KASIRGA-KIZIL/tekno-kizil/README.md

# tekno-kizil

## KASIRGA - KIZIL Takımı Teknofest 2023 Yonga Tasarımı

**TEKNOFEST 2023 Çip Tasarım Yarışması Sayısal İşlemci Kategorisi Birincisi**



**KIZIL İşlemci Projesi**

**Danışman:** &nbsp;&nbsp;&nbsp;&nbsp;&nbsp;&nbsp;&nbsp;&nbsp;&nbsp;Prof. Dr. Oğuz Ergin

**Takım Kaptanı:** &nbsp;&nbsp;Seyyid Hikmet Çelik

&emsp;&emsp;&emsp;&emsp;&emsp;&emsp;&emsp;&emsp;Emre Hakan Demirli

&emsp;&emsp;&emsp;&emsp;&emsp;&emsp;&emsp;&emsp;Mehmet Şakir Aslan

&emsp;&emsp;&emsp;&emsp;&emsp;&emsp;&emsp;&emsp;Ahmet Emre Oluk

&emsp;&emsp;&emsp;&emsp;&emsp;&emsp;&emsp;&emsp;Ege Deveci

**Youtube Sunum Videosu:**
https://www.youtube.com/watch?v=Kw16yyKHfTI

**Yarışma Sitesi:** 
https://teknofest.org/tr/competitions/competition/121

**Şartname (TR):** 
https://cdn.teknofest.org/media/upload/userFormUpload/Teknofest_%C3%87ip_%C5%9Eartnamesi_2023_v8_paylasilan_naLIQ.pdf

**Şartname (EN):**
https://cdn.teknofest.org/media/upload/userFormUpload/Teknofest_Chip_Specifications_2023_v5_paylasilan_kivby.pdf

## İşlemci Serimi

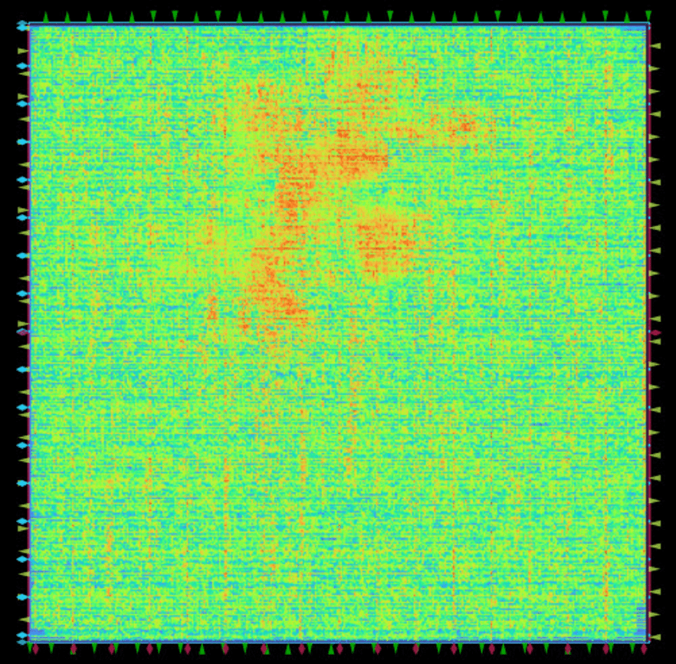
[picture p1: dokumanlar/islemci_serimi.png]


## İşlemci Özellikleri

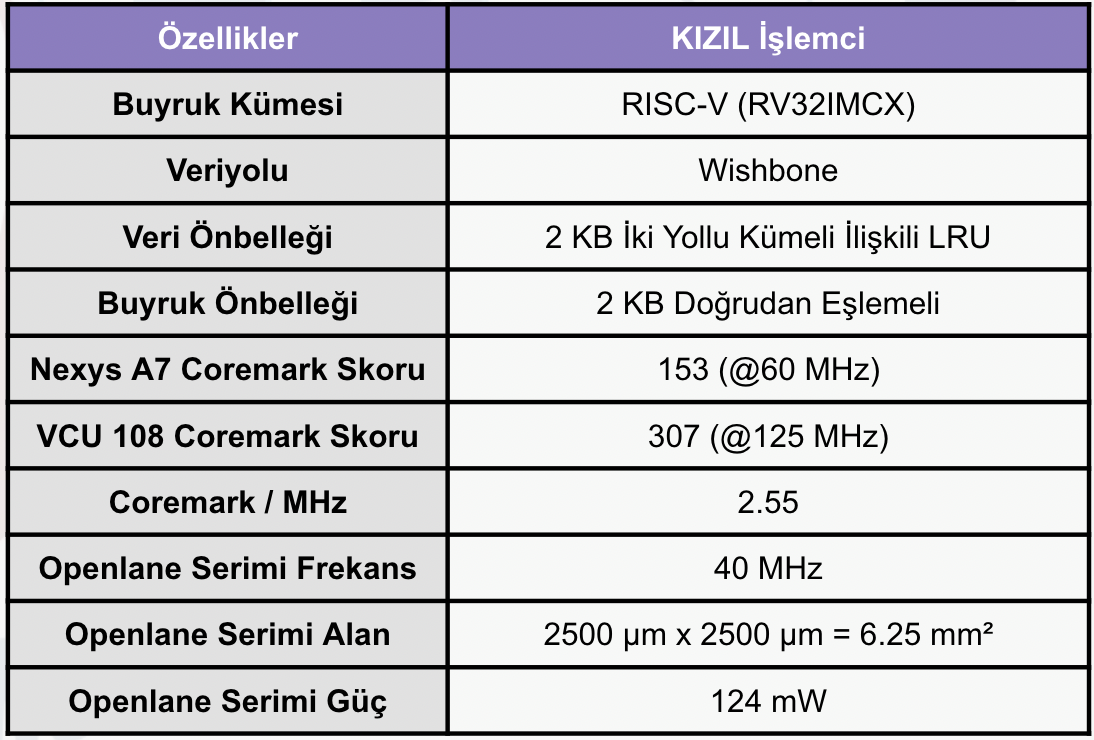
[picture p2: dokumanlar/islemci_ozellikleri_tablo.png]


## Sistem Yapısı

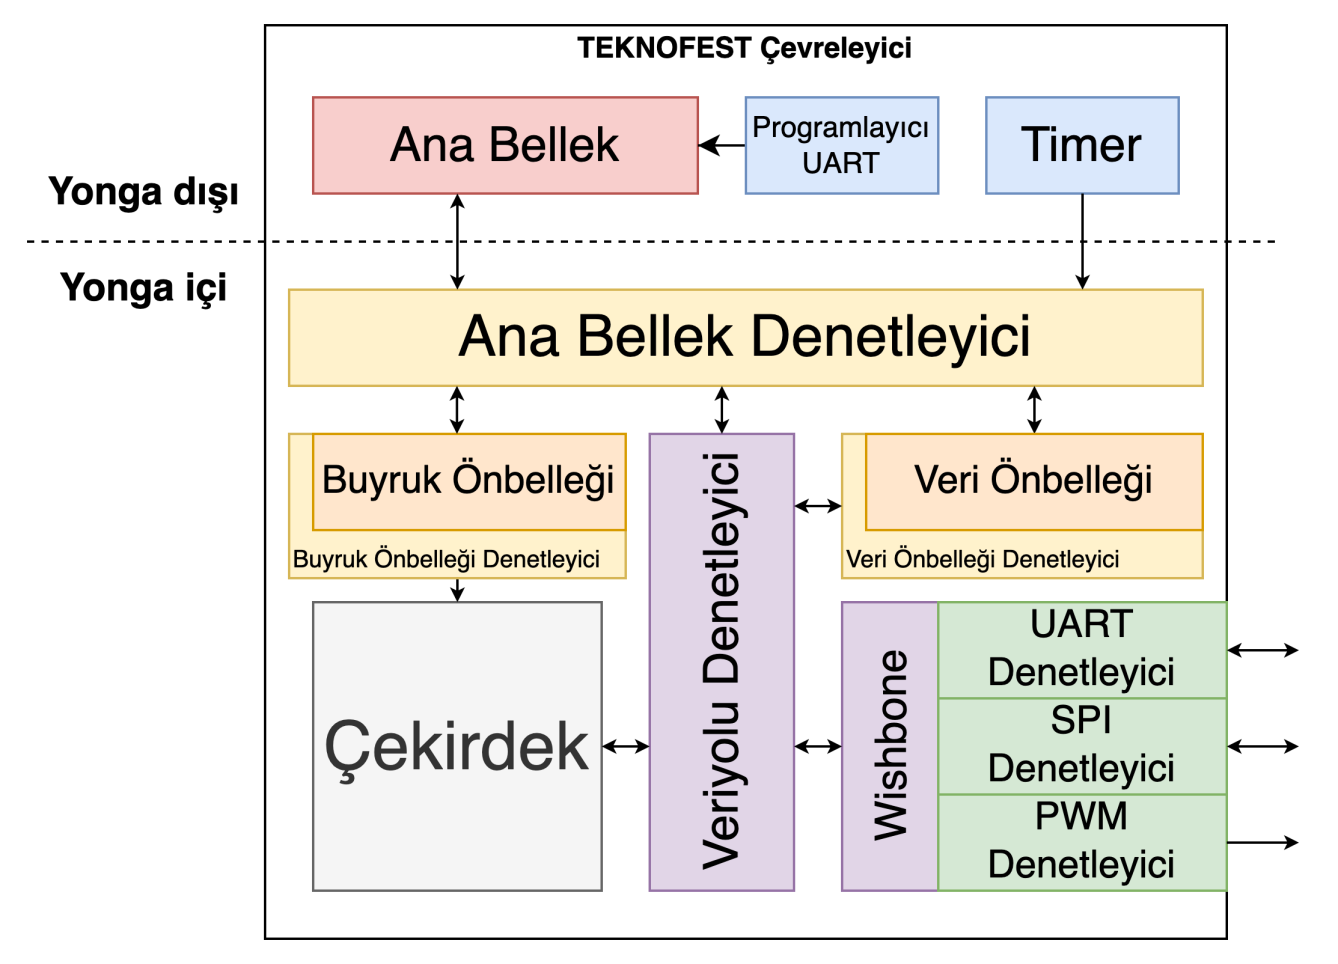
[picture p3: dokumanlar/sistem_yapisi_dtr.png]


## Çekirdek Yapısı - Boru Hattı

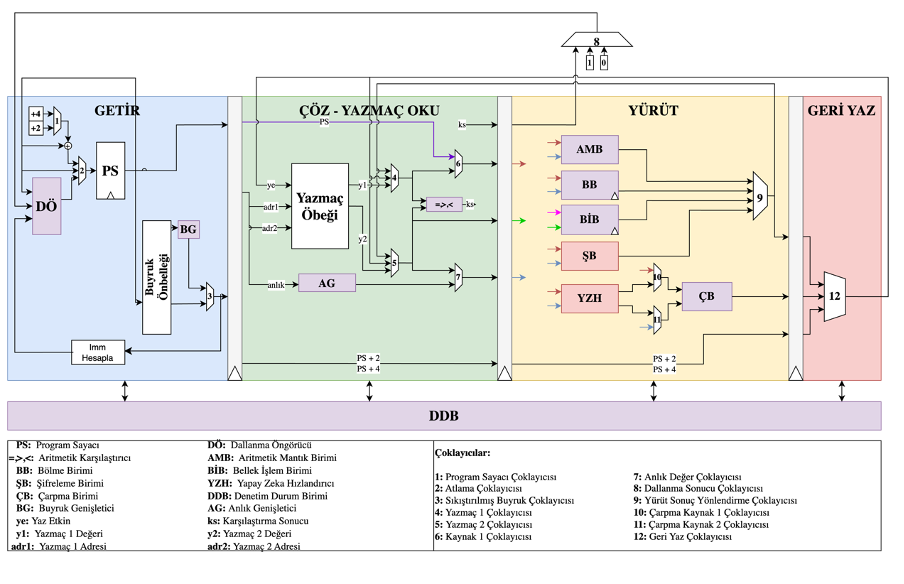
[picture p4: dokumanlar/cekirdek_yapisi_dtr.png]


## CoreMark Karşılaştırma Grafiği

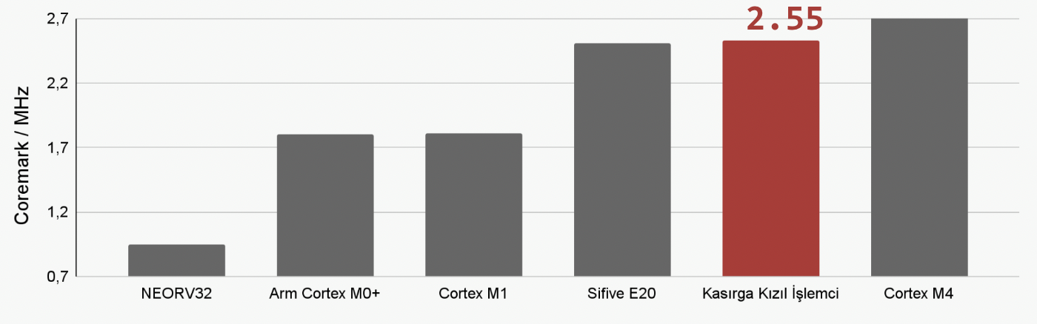
[picture p5: dokumanlar/coremark_karsilastirma.png]


## OPENLANE
OpenLane github dosyaları: ``` tekno-kizil/openlane/kizil_islemci```<br>
OpenLane commiti: ```commit dc8e6bb151df7ee2b93d7e9d6a15abf6f224db4d (HEAD, tag: 2023.03.12)```

open_pdks commiti: ```commit e6f9c8876da77220403014b116761b0b2d79aab4```

OpenLane dosyaları zip: 
https://drive.google.com/drive/folders/1dEIMV9H3JBl-_G-wRf3G_0qm45DjGziY?usp=sharing

Alternatif link:
https://etuedutr-my.sharepoint.com/:f:/g/personal/seyyidhikmetcelik_etu_edu_tr/En43TU66Nl1Ji5QVRtBFXAcBxOaddUdlfn2X91mqJWlFJw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
<br>
