KASIRGA-KIZIL/tekno-kizil/araclar/README.md

Uart programlayıcıyı basys3 gibi bir FPGA'e atarak ve python kodlarını kullanarak FPGA'yi programlayabilirsiniz.
