KASIRGA-KIZIL/tekno-kizil/vivado/README.md

## 3 FPGA İÇİN VIVADO DOSYALARI

NEXYS A7-100T --> 60 MHz 

*NEXYS için olan dosyalar teknofest_wrapper şeklinde, mesela teknofest_wrapper.bit, diğer fpgaler için kendi isminde*

VCU 108 --> 125 MHz (programlayıcı uart baudrate'i farklı --> 115200)

BASYS3 --> 60 MHz (sığmadığı için rami daha az --> 0x20000 yerine 0x5000 satır)
