KASIRGA-KIZIL/tekno-kizil/dokumanlar/cekirdek_yapisi.png

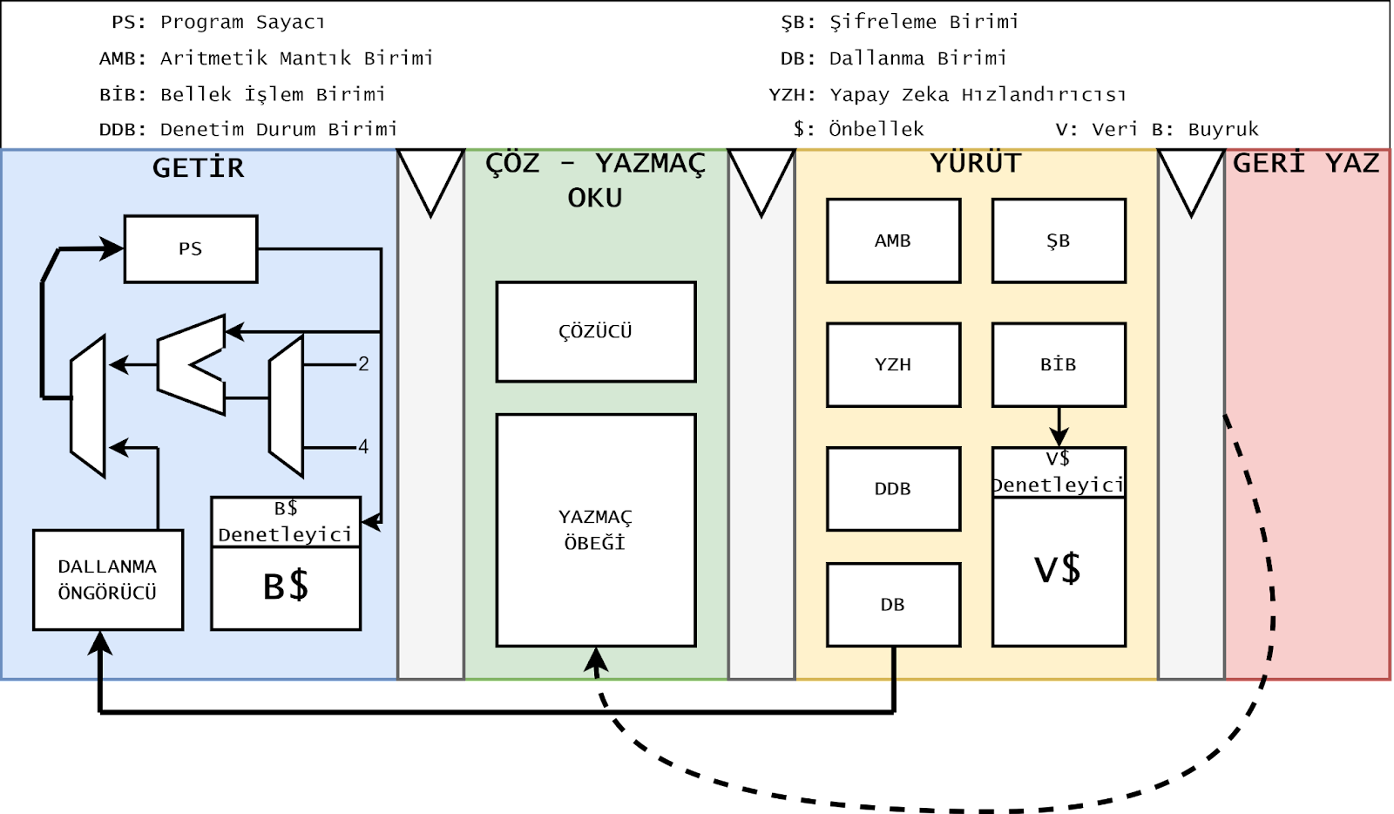
dokumanlar/cekirdek_yapisi.png
