KASIRGA-KIZIL/tekno-kizil/dokumanlar/cekirdek_yapisi_detayli.png

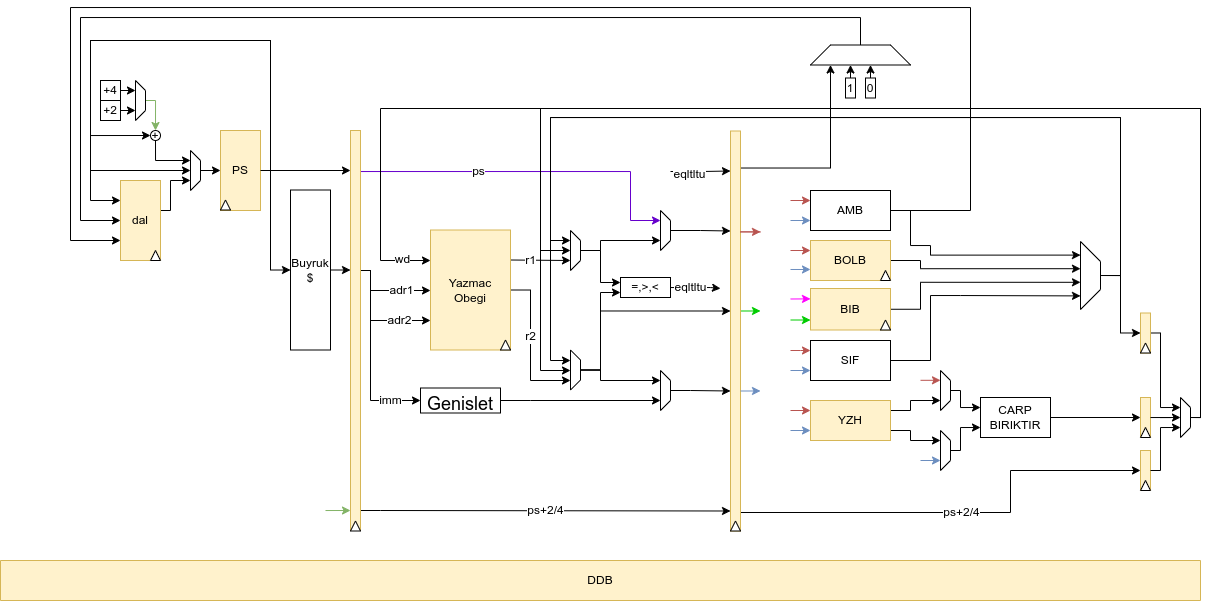
dokumanlar/cekirdek_yapisi_detayli.png
