KASIRGA-KIZIL/tekno-kizil/dokumanlar/sistem_yapisi_detayli.png

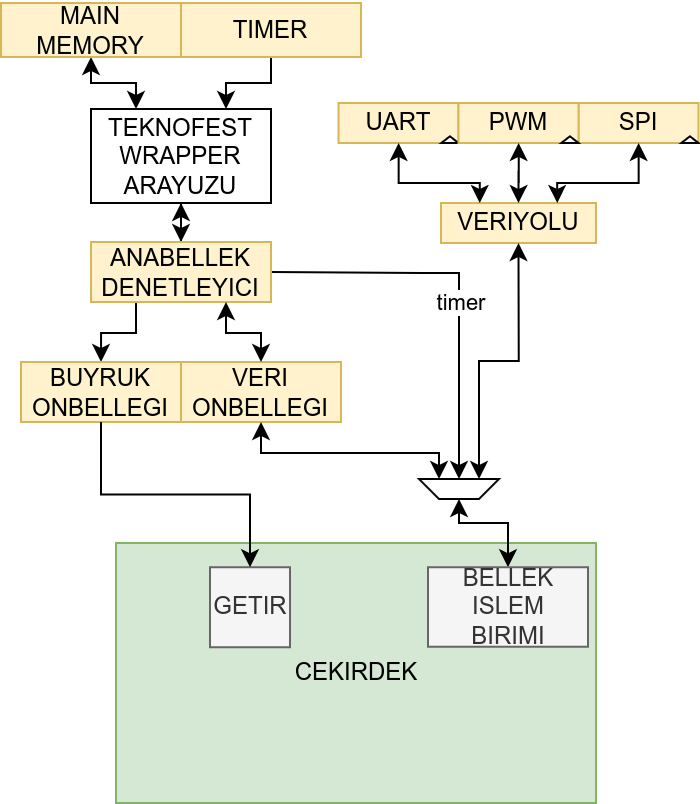
dokumanlar/sistem_yapisi_detayli.png
