KASIRGA-KIZIL/tekno-kizil/testler/spi-demo/spi_demo_disassembled.txt

spi_demo.riscv:     file format elf32-littleriscv

Disassembly of section .text:

40000000 <main>:
40000000:	200107b7          	lui	x15,0x20010
40000004:	09800713          	addi	x14,x0,152
40000008:	00e7a623          	sw	x14,12(x15) # 2001000c <main-0x1ffefff4>
4000000c:	000f0737          	lui	x14,0xf0
40000010:	00170713          	addi	x14,x14,1 # f0001 <main-0x3ff0ffff>
40000014:	00e7a023          	sw	x14,0(x15)
40000018:	00002737          	lui	x14,0x2
4000001c:	00e7a823          	sw	x14,16(x15)
40000020:	20010737          	lui	x14,0x20010
40000024:	00472783          	lw	x15,4(x14) # 20010004 <main-0x1ffefffc>
40000028:	0027f793          	andi	x15,x15,2
4000002c:	fe078ce3          	beq	x15,x0,40000024 <main+0x24>
40000030:	09800793          	addi	x15,x0,152
40000034:	00f72623          	sw	x15,12(x14)
40000038:	000f07b7          	lui	x15,0xf0
4000003c:	00578793          	addi	x15,x15,5 # f0005 <main-0x3ff0fffb>
40000040:	00f72023          	sw	x15,0(x14)
40000044:	000027b7          	lui	x15,0x2
40000048:	00f72823          	sw	x15,16(x14)
4000004c:	20010737          	lui	x14,0x20010
40000050:	00472783          	lw	x15,4(x14) # 20010004 <main-0x1ffefffc>
40000054:	0027f793          	andi	x15,x15,2
40000058:	fe078ce3          	beq	x15,x0,40000050 <main+0x50>
4000005c:	09800793          	addi	x15,x0,152
40000060:	00f72623          	sw	x15,12(x14)
40000064:	000f07b7          	lui	x15,0xf0
40000068:	00978793          	addi	x15,x15,9 # f0009 <main-0x3ff0fff7>
4000006c:	00f72023          	sw	x15,0(x14)
40000070:	000027b7          	lui	x15,0x2
40000074:	00f72823          	sw	x15,16(x14)
40000078:	20010737          	lui	x14,0x20010
4000007c:	00472783          	lw	x15,4(x14) # 20010004 <main-0x1ffefffc>
40000080:	0027f793          	andi	x15,x15,2
40000084:	fe078ce3          	beq	x15,x0,4000007c <main+0x7c>
40000088:	09800793          	addi	x15,x0,152
4000008c:	00f72623          	sw	x15,12(x14)
40000090:	000f07b7          	lui	x15,0xf0
40000094:	00d78793          	addi	x15,x15,13 # f000d <main-0x3ff0fff3>
40000098:	00f72023          	sw	x15,0(x14)
4000009c:	000027b7          	lui	x15,0x2
400000a0:	00f72823          	sw	x15,16(x14)
400000a4:	0000006f          	jal	x0,400000a4 <main+0xa4>
