KASIRGA-KIZIL/tekno-kizil/(threads)

Thread 8 (2023-05-05):

SPI mode 3 is non functional

hakan-demirli, 2023-05-05:
mode 3 in SPI read operation is broken. Incoming data is shifted by 4 bits.
