KASIRGA-KIZIL/tekno-kizil/openlane/kizil_islemci/src/toplayici.v

`include "tanimlamalar.vh"

`ifndef OPENLANE
// https://github.com/tdene/synth_opt_adders tarafindan olusturulmus optimize toplayici
/*
	width = 33
	f = forest(width, alias = "sklansky")
	f.hdl('adder_mapped.v', optimization = 0, mapping = "sky130_fd_sc_hd") # ayrica aynisinin behavioural versiyonu
*/
module toplayici(
	input  [32:0] a_in,
	input  [32:0] b_in,
	output [32:0] sum
);
	wire n8_tree_32, n9_tree_32, n10_tree_32, n11_tree_32, n12_tree_32, n13_tree_32, n16_tree_32, n17_tree_32, n18_tree_31, n18_tree_32, n19_tree_31, n19_tree_32, n20_tree_32, n21_tree_32, n24_tree_32, n25_tree_32, n26_tree_32, n27_tree_32, n28_tree_32, n29_tree_32, n32_tree_32, n33_tree_32, n34_tree_31, n34_tree_32, n35_tree_31, n35_tree_32, n36_tree_32, n37_tree_32, n38_tree_30, n39_tree_30, n40_tree_32, n41_tree_32, n42_tree_32, n43_tree_32, n44_tree_32, n45_tree_32, n48_tree_32, n49_tree_32, n50_tree_31, n50_tree_32, n51_tree_31, n51_tree_32, n52_tree_32, n53_tree_32, n56_tree_32, n57_tree_32, n58_tree_32, n59_tree_32, n60_tree_32, n61_tree_32, n64_tree_32, n65_tree_32, n66_tree_31, n66_tree_32, n67_tree_31, n67_tree_32, n68_tree_32, n69_tree_32, n70_tree_30, n71_tree_30, n72_tree_32, n73_tree_32, n74_tree_32, n75_tree_32, n76_tree_32, n77_tree_32, n80_tree_32, n81_tree_32, n82_tree_31, n82_tree_32, n83_tree_31, n83_tree_32, n84_tree_32, n85_tree_32, n88_tree_32, n89_tree_32, n90_tree_32, n91_tree_32, n92_tree_32, n93_tree_32, n96_tree_32, n97_tree_32, n98_tree_31, n98_tree_32, n99_tree_31, n99_tree_32, n100_tree_32, n101_tree_32, n104_tree_32, n105_tree_32, n106_tree_32, n107_tree_32, n108_tree_32, n109_tree_32, n112_tree_32, n113_tree_32, n114_tree_28, n114_tree_32, n115_tree_32, n116_tree_32, n117_tree_32, n119_tree_29, n120_tree_32, n121_tree_32, n124_tree_30, n124_tree_32, n125_tree_32, n129_tree_31, n134_tree_32;

	adder_tree_32 U0(
		.a_in(a_in[32:0]),
		.b_in(b_in[32:0]),
		.sum(sum[32]),
		.n125_tree_32(n125_tree_32),
		.n124_tree_32(n124_tree_32),
		.n121_tree_32(n121_tree_32),
		.n120_tree_32(n120_tree_32),
		.n117_tree_32(n117_tree_32),
		.n116_tree_32(n116_tree_32),
		.n113_tree_32(n113_tree_32),
		.n112_tree_32(n112_tree_32),
		.n109_tree_32(n109_tree_32),
		.n108_tree_32(n108_tree_32),
		.n105_tree_32(n105_tree_32),
		.n104_tree_32(n104_tree_32),
		.n101_tree_32(n101_tree_32),
		.n100_tree_32(n100_tree_32),
		.n97_tree_32(n97_tree_32),
		.n96_tree_32(n96_tree_32),
		.n93_tree_32(n93_tree_32),
		.n92_tree_32(n92_tree_32),
		.n89_tree_32(n89_tree_32),
		.n88_tree_32(n88_tree_32),
		.n85_tree_32(n85_tree_32),
		.n84_tree_32(n84_tree_32),
		.n81_tree_32(n81_tree_32),
		.n80_tree_32(n80_tree_32),
		.n77_tree_32(n77_tree_32),
		.n76_tree_32(n76_tree_32),
		.n73_tree_32(n73_tree_32),
		.n72_tree_32(n72_tree_32),
		.n69_tree_32(n69_tree_32),
		.n68_tree_32(n68_tree_32),
		.n65_tree_32(n65_tree_32),
		.n64_tree_32(n64_tree_32),
		.n61_tree_32(n61_tree_32),
		.n60_tree_32(n60_tree_32),
		.n57_tree_32(n57_tree_32),
		.n56_tree_32(n56_tree_32),
		.n53_tree_32(n53_tree_32),
		.n52_tree_32(n52_tree_32),
		.n49_tree_32(n49_tree_32),
		.n48_tree_32(n48_tree_32),
		.n45_tree_32(n45_tree_32),
		.n44_tree_32(n44_tree_32),
		.n41_tree_32(n41_tree_32),
		.n40_tree_32(n40_tree_32),
		.n37_tree_32(n37_tree_32),
		.n36_tree_32(n36_tree_32),
		.n33_tree_32(n33_tree_32),
		.n32_tree_32(n32_tree_32),
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
    assign n133_tree_32 = (n134_tree_32&n125_tree_32)|n124_tree_32;
    assign n134_tree_32 = a_in[0]&b_in[0];
    assign sum = n129_tree_32^n135_tree_32;
    assign n135_tree_32 = a_in[32]^b_in[32];
endmodule // adder_tree_32
`endif
