KASIRGA-KIZIL/tekno-kizil/openlane/kizil_islemci/src/toplayici_sky130.v

`include "tanimlamalar.vh"

`ifdef OPENLANE

module toplayici_sky130(
	input  [32:0] a_in,
	input  [32:0] b_in,
	output [32:0] sum
);
	wire n8_tree_32, n9_tree_32, n10_tree_32, n11_tree_32, n12_tree_32, n13_tree_32, n16_tree_32, n17_tree_32, n18_tree_31, n18_tree_32, n19_tree_31, n19_tree_32, n20_tree_32, n21_tree_32, n24_tree_32, n25_tree_32, n26_tree_32, n27_tree_32, n28_tree_32, n29_tree_32, n32_tree_32, n33_tree_32, n34_tree_31, n34_tree_32, n35_tree_31, n35_tree_32, n36_tree_32, n37_tree_32, n38_tree_30, n39_tree_30, n40_tree_32, n41_tree_32, n42_tree_32, n43_tree_32, n44_tree_32, n45_tree_32, n48_tree_32, n49_tree_32, n50_tree_31, n50_tree_32, n51_tree_31, n51_tree_32, n52_tree_32, n53_tree_32, n56_tree_32, n57_tree_32, n58_tree_32, n59_tree_32, n60_tree_32, n61_tree_32, n64_tree_32, n65_tree_32, n66_tree_31, n66_tree_32, n67_tree_31, n67_tree_32, n68_tree_32, n69_tree_32, n70_tree_30, n71_tree_30, n72_tree_32, n73_tree_32, n74_tree_32, n75_tree_32, n76_tree_32, n77_tree_32, n80_tree_32, n81_tree_32, n82_tree_29, n82_tree_31, n82_tree_32, n83_tree_29, n83_tree_31, n83_tree_32, n84_tree_32, n85_tree_32, n88_tree_32, n89_tree_32, n90_tree_32, n91_tree_32, n92_tree_32, n93_tree_32, n96_tree_32, n97_tree_32, n98_tree_31, n98_tree_32, n99_tree_31, n99_tree_32, n100_tree_32, n101_tree_32, n102_tree_30, n103_tree_30, n104_tree_32, n105_tree_32, n106_tree_32, n107_tree_32, n108_tree_32, n109_tree_32, n112_tree_32, n113_tree_32, n114_tree_31, n114_tree_32, n115_tree_31, n115_tree_32, n116_tree_32, n117_tree_32, n120_tree_32, n121_tree_32, n122_tree_32, n123_tree_32, n124_tree_32, n125_tree_32, n126_tree_32, n127_tree_32;

	adder_tree_32 U0(
		.a_in(a_in[32:0]),
		.b_in(b_in[32:0]),
		.sum(sum[32]),
		.n127_tree_32(n127_tree_32),
		.n126_tree_32(n126_tree_32),
		.n125_tree_32(n125_tree_32),
		.n124_tree_32(n124_tree_32),
		.n121_tree_32(n121_tree_32),
		.n120_tree_32(n120_tree_32),
		.n117_tree_32(n117_tree_32),
		.n116_tree_32(n116_tree_32),
		.n113_tree_32(n113_tree_32),
		.n112_tree_32(n112_tree_32),
		.n109_tree_32(n109_tree_32),
		.n108_tree_32(n108_tree_32),
		.n105_tree_32(n105_tree_32),
		.n104_tree_32(n104_tree_32),
		.n101_tree_32(n101_tree_32),
		.n100_tree_32(n100_tree_32),
		.n97_tree_32(n97_tree_32),
		.n96_tree_32(n96_tree_32),
		.n93_tree_32(n93_tree_32),
		.n92_tree_32(n92_tree_32),
		.n89_tree_32(n89_tree_32),
		.n88_tree_32(n88_tree_32),
		.n85_tree_32(n85_tree_32),
		.n84_tree_32(n84_tree_32),
		.n81_tree_32(n81_tree_32),
		.n80_tree_32(n80_tree_32),
		.n77_tree_32(n77_tree_32),
		.n76_tree_32(n76_tree_32),
		.n73_tree_32(n73_tree_32),
		.n72_tree_32(n72_tree_32),
		.n69_tree_32(n69_tree_32),
		.n68_tree_32(n68_tree_32),
		.n65_tree_32(n65_tree_32),
		.n64_tree_32(n64_tree_32),
		.n61_tree_32(n61_tree_32),
		.n60_tree_32(n60_tree_32),
		.n57_tree_32(n57_tree_32),
		.n56_tree_32(n56_tree_32),
		.n53_tree_32(n53_tree_32),
		.n52_tree_32(n52_tree_32),
		.n49_tree_32(n49_tree_32),
		.n48_tree_32(n48_tree_32),
		.n45_tree_32(n45_tree_32),
		.n44_tree_32(n44_tree_32),
		.n41_tree_32(n41_tree_32),
		.n40_tree_32(n40_tree_32),
		.n37_tree_32(n37_tree_32),
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
	input   n26_tree_32,
	input   n27_tree_32,
	input   n38_tree_30,
	input   n39_tree_30,
	input   n82_tree_29,
	input   n83_tree_29,
	output  sum
);
// adder_forest tree_27
	wire n1_tree_27, n2_tree_27, n3_tree_27, n10_tree_27, n11_tree_27, n42_tree_27, n43_tree_27, n108_tree_27;
    sky130_fd_sc_hd__mux2_1 U111(.X(sum), .S(n42_tree_27), .A0(n1_tree_27), .A1(n2_tree_27));
    sky130_fd_sc_hd__xor2_1 U64(.X(n1_tree_27), .A(a_in[27]), .B(b_in[27]));
    sky130_fd_sc_hd__xnor2_1 U65(.Y(n2_tree_27), .A(a_in[27]), .B(b_in[27]));
    sky130_fd_sc_hd__and2_1 U74(.X(n108_tree_27), .A(n25_tree_32), .B(n27_tree_32));
    sky130_fd_sc_hd__a21o_1 U75(.X(n3_tree_27), .A1(n26_tree_32), .A2(n25_tree_32), .B1(n24_tree_32));
    sky130_fd_sc_hd__and2_1 U93(.X(n11_tree_27), .A(n108_tree_27), .B(n39_tree_30));
    sky130_fd_sc_hd__a21o_1 U94(.X(n10_tree_27), .A1(n38_tree_30), .A2(n108_tree_27), .B1(n3_tree_27));
    sky130_fd_sc_hd__and2_1 U149(.X(n43_tree_27), .A(n11_tree_27), .B(n83_tree_29));
    sky130_fd_sc_hd__a21o_1 U150(.X(n42_tree_27), .A1(n82_tree_29), .A2(n11_tree_27), .B1(n10_tree_27));
endmodule // adder_tree_27
module adder_tree_28(
	input  [28:0] a_in,
	input  [28:0] b_in,
	input   n18_tree_31,
	input   n19_tree_31,
	input   n38_tree_30,
	input   n39_tree_30,
	input   n82_tree_29,
	input   n83_tree_29,
	output  sum
);
// adder_forest tree_28
	wire n1_tree_28, n2_tree_28, n14_tree_28, n15_tree_28, n46_tree_28, n47_tree_28;
    sky130_fd_sc_hd__mux2_1 U100(.X(sum), .S(n46_tree_28), .A0(n1_tree_28), .A1(n2_tree_28));
    sky130_fd_sc_hd__xor2_1 U62(.X(n1_tree_28), .A(a_in[28]), .B(b_in[28]));
    sky130_fd_sc_hd__xnor2_1 U63(.Y(n2_tree_28), .A(a_in[28]), .B(b_in[28]));
    sky130_fd_sc_hd__and2_1 U103(.X(n15_tree_28), .A(n19_tree_31), .B(n39_tree_30));
    sky130_fd_sc_hd__a21o_1 U104(.X(n14_tree_28), .A1(n38_tree_30), .A2(n19_tree_31), .B1(n18_tree_31));
    sky130_fd_sc_hd__and2_1 U162(.X(n47_tree_28), .A(n15_tree_28), .B(n83_tree_29));
    sky130_fd_sc_hd__a21o_1 U163(.X(n46_tree_28), .A1(n82_tree_29), .A2(n15_tree_28), .B1(n14_tree_28));
endmodule // adder_tree_28
module adder_tree_29(
	input  [29:0] a_in,
	input  [29:0] b_in,
	input   n17_tree_32,
	input   n16_tree_32,
	input   n18_tree_31,
	input   n19_tree_31,
	input   n38_tree_30,
	input   n39_tree_30,
	input   n70_tree_30,
	input   n71_tree_30,
	input   n102_tree_30,
	input   n103_tree_30,
	output  sum,
	output  n82_tree_29,
	output  n83_tree_29
);
// adder_forest tree_29
	wire n1_tree_29, n2_tree_29, n3_tree_29, n18_tree_29, n19_tree_29, n50_tree_29, n51_tree_29, n116_tree_29;
    sky130_fd_sc_hd__mux2_1 U97(.X(sum), .S(n50_tree_29), .A0(n1_tree_29), .A1(n2_tree_29));
    sky130_fd_sc_hd__xor2_1 U79(.X(n1_tree_29), .A(a_in[29]), .B(b_in[29]));
    sky130_fd_sc_hd__xnor2_1 U80(.Y(n2_tree_29), .A(a_in[29]), .B(b_in[29]));
    sky130_fd_sc_hd__and2_1 U89(.X(n116_tree_29), .A(n17_tree_32), .B(n19_tree_31));
    sky130_fd_sc_hd__a21o_1 U90(.X(n3_tree_29), .A1(n18_tree_31), .A2(n17_tree_32), .B1(n16_tree_32));
    sky130_fd_sc_hd__and2_1 U124(.X(n19_tree_29), .A(n116_tree_29), .B(n39_tree_30));
    sky130_fd_sc_hd__a21o_1 U125(.X(n18_tree_29), .A1(n38_tree_30), .A2(n116_tree_29), .B1(n3_tree_29));
    sky130_fd_sc_hd__and2_1 U186(.X(n51_tree_29), .A(n19_tree_29), .B(n83_tree_29));
    sky130_fd_sc_hd__a21o_1 U187(.X(n50_tree_29), .A1(n82_tree_29), .A2(n19_tree_29), .B1(n18_tree_29));
    sky130_fd_sc_hd__and2_1 U243(.X(n83_tree_29), .A(n71_tree_30), .B(n103_tree_30));
    sky130_fd_sc_hd__a21o_1 U244(.X(n82_tree_29), .A1(n102_tree_30), .A2(n71_tree_30), .B1(n70_tree_30));
endmodule // adder_tree_29
module adder_tree_30(
	input  [30:0] a_in,
	input  [30:0] b_in,
	input   n10_tree_32,
	input   n11_tree_32,
	input   n18_tree_31,
	input   n19_tree_31,
	input   n34_tree_31,
	input   n35_tree_31,
	input   n50_tree_31,
	input   n51_tree_31,
	input   n66_tree_31,
	input   n67_tree_31,
	input   n82_tree_31,
	input   n83_tree_31,
	input   n98_tree_31,
	input   n99_tree_31,
	input   n114_tree_31,
	input   n115_tree_31,
	output  sum,
	output  n38_tree_30,
	output  n39_tree_30,
	output  n70_tree_30,
	output  n71_tree_30,
	output  n102_tree_30,
	output  n103_tree_30
);
// adder_forest tree_30
	wire n1_tree_30, n2_tree_30, n6_tree_30, n7_tree_30, n22_tree_30, n23_tree_30, n54_tree_30, n55_tree_30, n86_tree_30, n87_tree_30;
    sky130_fd_sc_hd__mux2_1 U113(.X(sum), .S(n54_tree_30), .A0(n1_tree_30), .A1(n2_tree_30));
    sky130_fd_sc_hd__xor2_1 U105(.X(n1_tree_30), .A(a_in[30]), .B(b_in[30]));
    sky130_fd_sc_hd__xnor2_1 U106(.Y(n2_tree_30), .A(a_in[30]), .B(b_in[30]));
    sky130_fd_sc_hd__and2_1 U122(.X(n7_tree_30), .A(n11_tree_32), .B(n19_tree_31));
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
    sky130_fd_sc_hd__and2_1 U56(.X(n119_tree_32), .A(n115_tree_32), .B(n123_tree_32));
    sky130_fd_sc_hd__a21o_1 U57(.X(n118_tree_32), .A1(n122_tree_32), .A2(n115_tree_32), .B1(n114_tree_32));
    sky130_fd_sc_hd__and2_1 U67(.X(n123_tree_32), .A(n125_tree_32), .B(n127_tree_32));
    sky130_fd_sc_hd__a21o_1 U68(.X(n122_tree_32), .A1(n126_tree_32), .A2(n125_tree_32), .B1(n124_tree_32));
endmodule // adder_tree_32
`endif
