KASIRGA-KIZIL/tekno-kizil/openlane/kizil_islemci/src/carp_biriktir.v

// Note: The license below is based on the template at:
// http://opensource.org/licenses/BSD-3-Clause
// Copyright (C) 2020 Regents of the University of Texas
//All rights reserved.

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
// o Redistributions of source code must retain the above copyright
//   notice, this list of conditions and the following disclaimer.

// o Redistributions in binary form must reproduce the above copyright
//   notice, this list of conditions and the following disclaimer in the
//   documentation and/or other materials provided with the distribution.

// o Neither the name of the copyright holders nor the names of its
//   contributors may be used to endorse or promote products derived
//   from this software without specific prior written permission.

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
// Original Author(s):
// Mertcan Temel         <mert@utexas.edu>

// DO NOT REMOVE:
// This file is generated by Temel's multiplier generator. Download from https://github.com/temelmertcan/multgen.


// DEGISIKLIKLER:
// Icerideki carpma biriminin cikisi register'lanmistir.

`timescale 1ns / 1ps


module carp_biriktir(
    input wire clk_i,
    input wire rst_i,
    input wire durdur_i,
    input wire [32:0] IN1,
    input wire [32:0] IN2,
    output reg [66:0] result);
wire [66:0] m1_0;
wire [66:0] m1_1;
DT_SB4_33x33_67 m1 (IN1[32:0], IN2[32:0], m1_0, m1_1);


reg [32:0] IN3;
// Dadda Summation Stage 1
wire s0 ,c0;
ha ha0 (m1_0[32], m1_1[32], s0, c0);

// Dadda Summation Stage 2
wire s1 ,c1;
ha ha1 (m1_0[0], m1_1[0], s1, c1);
wire s2 ,c2;
ha ha2 (m1_0[1], IN3[1], s2, c2);
wire s3 ,c3;
fa fa3 (m1_0[2], m1_1[2], IN3[2], s3, c3);
wire s4 ,c4;
fa fa4 (m1_0[3], m1_1[3], IN3[3], s4, c4);
wire s5 ,c5;
fa fa5 (m1_0[4], m1_1[4], IN3[4], s5, c5);
wire s6 ,c6;
fa fa6 (m1_0[5], m1_1[5], IN3[5], s6, c6);
wire s7 ,c7;
fa fa7 (m1_0[6], m1_1[6], IN3[6], s7, c7);
wire s8 ,c8;
fa fa8 (m1_0[7], m1_1[7], IN3[7], s8, c8);
wire s9 ,c9;
fa fa9 (m1_0[8], m1_1[8], IN3[8], s9, c9);
wire s10 ,c10;
fa fa10 (m1_0[9], m1_1[9], IN3[9], s10, c10);
wire s11 ,c11;
fa fa11 (m1_0[10], m1_1[10], IN3[10], s11, c11);
wire s12 ,c12;
fa fa12 (m1_0[11], m1_1[11], IN3[11], s12, c12);
wire s13 ,c13;
fa fa13 (m1_0[12], m1_1[12], IN3[12], s13, c13);
wire s14 ,c14;
fa fa14 (m1_0[13], m1_1[13], IN3[13], s14, c14);
wire s15 ,c15;
fa fa15 (m1_0[14], m1_1[14], IN3[14], s15, c15);
wire s16 ,c16;
fa fa16 (m1_0[15], m1_1[15], IN3[15], s16, c16);
wire s17 ,c17;
fa fa17 (m1_0[16], m1_1[16], IN3[16], s17, c17);
wire s18 ,c18;
fa fa18 (m1_0[17], m1_1[17], IN3[17], s18, c18);
wire s19 ,c19;
fa fa19 (m1_0[18], m1_1[18], IN3[18], s19, c19);
wire s20 ,c20;
fa fa20 (m1_0[19], m1_1[19], IN3[19], s20, c20);
wire s21 ,c21;
fa fa21 (m1_0[20], m1_1[20], IN3[20], s21, c21);
wire s22 ,c22;
fa fa22 (m1_0[21], m1_1[21], IN3[21], s22, c22);
wire s23 ,c23;
fa fa23 (m1_0[22], m1_1[22], IN3[22], s23, c23);
wire s24 ,c24;
fa fa24 (m1_0[23], m1_1[23], IN3[23], s24, c24);
wire s25 ,c25;
fa fa25 (m1_0[24], m1_1[24], IN3[24], s25, c25);
wire s26 ,c26;
fa fa26 (m1_0[25], m1_1[25], IN3[25], s26, c26);
wire s27 ,c27;
fa fa27 (m1_0[26], m1_1[26], IN3[26], s27, c27);
wire s28 ,c28;
fa fa28 (m1_0[27], m1_1[27], IN3[27], s28, c28);
wire s29 ,c29;
fa fa29 (m1_0[28], m1_1[28], IN3[28], s29, c29);
wire s30 ,c30;
fa fa30 (m1_0[29], m1_1[29], IN3[29], s30, c30);
wire s31 ,c31;
fa fa31 (m1_0[30], m1_1[30], IN3[30], s31, c31);
wire s32 ,c32;
fa fa32 (m1_0[31], m1_1[31], IN3[31], s32, c32);
wire s33 ,c33;
fa fa33 (~IN3[32], 1'b1, s0, s33, c33);
wire s34 ,c34;
fa fa34 (m1_0[33], m1_1[33], c0, s34, c34);
wire s35 ,c35;
fa fa35 (m1_0[34], m1_1[34], 1'b1, s35, c35);
wire s36 ,c36;
ha ha36 (m1_0[35], m1_1[35], s36, c36);
wire s37 ,c37;
fa fa37 (m1_0[36], m1_1[36], 1'b1, s37, c37);
wire s38 ,c38;
ha ha38 (m1_0[37], m1_1[37], s38, c38);
wire s39 ,c39;
fa fa39 (m1_0[38], m1_1[38], 1'b1, s39, c39);
wire s40 ,c40;
ha ha40 (m1_0[39], m1_1[39], s40, c40);
wire s41 ,c41;
fa fa41 (m1_0[40], m1_1[40], 1'b1, s41, c41);
wire s42 ,c42;
ha ha42 (m1_0[41], m1_1[41], s42, c42);
wire s43 ,c43;
fa fa43 (m1_0[42], m1_1[42], 1'b1, s43, c43);
wire s44 ,c44;
ha ha44 (m1_0[43], m1_1[43], s44, c44);
wire s45 ,c45;
fa fa45 (m1_0[44], m1_1[44], 1'b1, s45, c45);
wire s46 ,c46;
ha ha46 (m1_0[45], m1_1[45], s46, c46);
wire s47 ,c47;
fa fa47 (m1_0[46], m1_1[46], 1'b1, s47, c47);
wire s48 ,c48;
ha ha48 (m1_0[47], m1_1[47], s48, c48);
wire s49 ,c49;
fa fa49 (m1_0[48], m1_1[48], 1'b1, s49, c49);
wire s50 ,c50;
ha ha50 (m1_0[49], m1_1[49], s50, c50);
wire s51 ,c51;
fa fa51 (m1_0[50], m1_1[50], 1'b1, s51, c51);
wire s52 ,c52;
ha ha52 (m1_0[51], m1_1[51], s52, c52);
wire s53 ,c53;
fa fa53 (m1_0[52], m1_1[52], 1'b1, s53, c53);
wire s54 ,c54;
ha ha54 (m1_0[53], m1_1[53], s54, c54);
wire s55 ,c55;
fa fa55 (m1_0[54], m1_1[54], 1'b1, s55, c55);
wire s56 ,c56;
ha ha56 (m1_0[55], m1_1[55], s56, c56);
wire s57 ,c57;
fa fa57 (m1_0[56], m1_1[56], 1'b1, s57, c57);
wire s58 ,c58;
ha ha58 (m1_0[57], m1_1[57], s58, c58);
wire s59 ,c59;
fa fa59 (m1_0[58], m1_1[58], 1'b1, s59, c59);
wire s60 ,c60;
ha ha60 (m1_0[59], m1_1[59], s60, c60);
wire s61 ,c61;
fa fa61 (m1_0[60], m1_1[60], 1'b1, s61, c61);
wire s62 ,c62;
ha ha62 (m1_0[61], m1_1[61], s62, c62);
wire s63 ,c63;
fa fa63 (m1_0[62], m1_1[62], 1'b1, s63, c63);
wire s64 ,c64;
ha ha64 (m1_0[63], m1_1[63], s64, c64);
wire s65 ,c65;
fa fa65 (m1_0[64], m1_1[64], 1'b1, s65, c65);

wire [67:0] adder_result;
KS_67 final_adder ({1'b1, m1_0[65], c64, c63, c62, c61, c60, c59, c58, c57, c56, c55, c54, c53, c52, c51, c50, c49, c48, c47, c46, c45, c44, c43, c42, c41, c40, c39, c38, c37, c36, c35, c34, c33, c32, c31, c30, c29, c28, c27, c26, c25, c24, c23, c22, c21, c20, c19, c18, c17, c16, c15, c14, c13, c12, c11, c10, c9, c8, c7, c6, c5, c4, c3, c2, c1, IN3[0] }, {1'b0, c65, s65, s64, s63, s62, s61, s60, s59, s58, s57, s56, s55, s54, s53, s52, s51, s50, s49, s48, s47, s46, s45, s44, s43, s42, s41, s40, s39, s38, s37, s36, s35, s34, s33, s32, s31, s30, s29, s28, s27, s26, s25, s24, s23, s22, s21, s20, s19, s18, s17, s16, s15, s14, s13, s12, s11, s10, s9, s8, s7, s6, s5, s4, s3, s2, s1 }, adder_result );
always @(posedge clk_i) begin
    if(rst_i)begin
        IN3    <= 33'b0;
    end else begin
        if(~durdur_i)
            IN3    <= adder_result[32:0];
    end
    if(~durdur_i)
        result <= adder_result[66:0];
end


endmodule



module DT_SB4_33x33_67(
    input wire [32:0] IN1,
    input wire [32:0] IN2,
    output wire [66:0] result0,
    output wire [66:0] result1);


// Creating Partial Products

wire [32:0] mult = IN1;
wire [32:0] mcand = IN2;
wire [33:0] mcand_1x;
wire [33:0] mcand_2x;
assign mcand_1x = {{1{mcand[32]}},  mcand};
assign mcand_2x = {{0{mcand[32]}},  mcand, 1'b0};

// Booth Radix-4 Partial Products. Multiplier selectors: mult[1] mult[0] 1'b0
wire select_e_0, select_2x_0, tcomp0, select_ne_0, select_n2x_0;
assign select_e_0 = ((~ mult[1]) & (mult[0] ^ 1'b0));
assign select_ne_0 = mult[1] &  (mult[0] ^ 1'b0);
assign select_2x_0 = (~ mult[1]) & mult[0] & 1'b0;
assign select_n2x_0 = mult[1] & (~ mult[0]) & (~ 1'b0);
wire [33:0] pp_0;
assign pp_0 = (1<<33) ^ // flip the MSB
               ((select_e_0 ? mcand_1x : 0) |
                (select_2x_0 ? mcand_2x : 0) |
                (select_n2x_0 ? (~ mcand_2x) : 0) |
                (select_ne_0 ? (~ mcand_1x) : 0));
assign tcomp0 =  select_n2x_0 | select_ne_0;

// Booth Radix-4 Partial Products. Multiplier selectors: mult[3] mult[2] mult[1]
wire select_e_1, select_2x_1, tcomp1, select_ne_1, select_n2x_1;
assign select_e_1 = ((~ mult[3]) & (mult[2] ^ mult[1]));
assign select_ne_1 = mult[3] &  (mult[2] ^ mult[1]);
assign select_2x_1 = (~ mult[3]) & mult[2] & mult[1];
assign select_n2x_1 = mult[3] & (~ mult[2]) & (~ mult[1]);
wire [33:0] pp_1;
assign pp_1 = (1<<33) ^ // flip the MSB
               ((select_e_1 ? mcand_1x : 0) |
                (select_2x_1 ? mcand_2x : 0) |
                (select_n2x_1 ? (~ mcand_2x) : 0) |
                (select_ne_1 ? (~ mcand_1x) : 0));
assign tcomp1 =  select_n2x_1 | select_ne_1;

// Booth Radix-4 Partial Products. Multiplier selectors: mult[5] mult[4] mult[3]
wire select_e_2, select_2x_2, tcomp2, select_ne_2, select_n2x_2;
assign select_e_2 = ((~ mult[5]) & (mult[4] ^ mult[3]));
assign select_ne_2 = mult[5] &  (mult[4] ^ mult[3]);
assign select_2x_2 = (~ mult[5]) & mult[4] & mult[3];
assign select_n2x_2 = mult[5] & (~ mult[4]) & (~ mult[3]);
wire [33:0] pp_2;
assign pp_2 = (1<<33) ^ // flip the MSB
               ((select_e_2 ? mcand_1x : 0) |
                (select_2x_2 ? mcand_2x : 0) |
                (select_n2x_2 ? (~ mcand_2x) : 0) |
                (select_ne_2 ? (~ mcand_1x) : 0));
assign tcomp2 =  select_n2x_2 | select_ne_2;

// Booth Radix-4 Partial Products. Multiplier selectors: mult[7] mult[6] mult[5]
wire select_e_3, select_2x_3, tcomp3, select_ne_3, select_n2x_3;
assign select_e_3 = ((~ mult[7]) & (mult[6] ^ mult[5]));
assign select_ne_3 = mult[7] &  (mult[6] ^ mult[5]);
assign select_2x_3 = (~ mult[7]) & mult[6] & mult[5];
assign select_n2x_3 = mult[7] & (~ mult[6]) & (~ mult[5]);
wire [33:0] pp_3;
assign pp_3 = (1<<33) ^ // flip the MSB
               ((select_e_3 ? mcand_1x : 0) |
                (select_2x_3 ? mcand_2x : 0) |
                (select_n2x_3 ? (~ mcand_2x) : 0) |
                (select_ne_3 ? (~ mcand_1x) : 0));
assign tcomp3 =  select_n2x_3 | select_ne_3;

// Booth Radix-4 Partial Products. Multiplier selectors: mult[9] mult[8] mult[7]
wire select_e_4, select_2x_4, tcomp4, select_ne_4, select_n2x_4;
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
assign pp_13 = (1<<33) ^ // flip the MSB
               ((select_e_13 ? mcand_1x : 0) |
                (select_2x_13 ? mcand_2x : 0) |
                (select_n2x_13 ? (~ mcand_2x) : 0) |
                (select_ne_13 ? (~ mcand_1x) : 0));
assign tcomp13 =  select_n2x_13 | select_ne_13;

// Booth Radix-4 Partial Products. Multiplier selectors: mult[29] mult[28] mult[27]
wire select_e_14, select_2x_14, tcomp14, select_ne_14, select_n2x_14;
assign select_e_14 = ((~ mult[29]) & (mult[28] ^ mult[27]));
assign select_ne_14 = mult[29] &  (mult[28] ^ mult[27]);
assign select_2x_14 = (~ mult[29]) & mult[28] & mult[27];
assign select_n2x_14 = mult[29] & (~ mult[28]) & (~ mult[27]);
wire [33:0] pp_14;
assign pp_14 = (1<<33) ^ // flip the MSB
               ((select_e_14 ? mcand_1x : 0) |
                (select_2x_14 ? mcand_2x : 0) |
                (select_n2x_14 ? (~ mcand_2x) : 0) |
                (select_ne_14 ? (~ mcand_1x) : 0));
assign tcomp14 =  select_n2x_14 | select_ne_14;

// Booth Radix-4 Partial Products. Multiplier selectors: mult[31] mult[30] mult[29]
wire select_e_15, select_2x_15, tcomp15, select_ne_15, select_n2x_15;
assign select_e_15 = ((~ mult[31]) & (mult[30] ^ mult[29]));
assign select_ne_15 = mult[31] &  (mult[30] ^ mult[29]);
assign select_2x_15 = (~ mult[31]) & mult[30] & mult[29];
assign select_n2x_15 = mult[31] & (~ mult[30]) & (~ mult[29]);
wire [33:0] pp_15;
assign pp_15 = (1<<33) ^ // flip the MSB
               ((select_e_15 ? mcand_1x : 0) |
                (select_2x_15 ? mcand_2x : 0) |
                (select_n2x_15 ? (~ mcand_2x) : 0) |
                (select_ne_15 ? (~ mcand_1x) : 0));
assign tcomp15 =  select_n2x_15 | select_ne_15;

// Booth Radix-4 Partial Products. Multiplier selectors: mult[32] mult[32] mult[31]
wire select_e_16, select_2x_16, tcomp16, select_ne_16, select_n2x_16;
assign select_e_16 = ((~ mult[32]) & (mult[32] ^ mult[31]));
assign select_ne_16 = mult[32] &  (mult[32] ^ mult[31]);
assign select_2x_16 = (~ mult[32]) & mult[32] & mult[31];
assign select_n2x_16 = mult[32] & (~ mult[32]) & (~ mult[31]);
wire [33:0] pp_16;
assign pp_16 = (1<<33) ^ // flip the MSB
               ((select_e_16 ? mcand_1x : 0) |
                (select_2x_16 ? mcand_2x : 0) |
                (select_n2x_16 ? (~ mcand_2x) : 0) |
                (select_ne_16 ? (~ mcand_1x) : 0));
assign tcomp16 =  select_n2x_16 | select_ne_16;

// Creating Summation Tree


// Dadda Summation Stage 1
wire s0 ,c0;
ha ha0 (pp_0[24], pp_1[22], s0, c0);
wire s1 ,c1;
ha ha1 (pp_0[25], pp_1[23], s1, c1);
wire s2 ,c2;
fa fa2 (pp_0[26], pp_1[24], pp_2[22], s2, c2);
wire s3 ,c3;
ha ha3 (pp_3[20], pp_4[18], s3, c3);
wire s4 ,c4;
fa fa4 (pp_0[27], pp_1[25], pp_2[23], s4, c4);
wire s5 ,c5;
ha ha5 (pp_3[21], pp_4[19], s5, c5);
wire s6 ,c6;
fa fa6 (pp_0[28], pp_1[26], pp_2[24], s6, c6);
wire s7 ,c7;
fa fa7 (pp_3[22], pp_4[20], pp_5[18], s7, c7);
wire s8 ,c8;
ha ha8 (pp_6[16], pp_7[14], s8, c8);
wire s9 ,c9;
fa fa9 (pp_0[29], pp_1[27], pp_2[25], s9, c9);
wire s10 ,c10;
fa fa10 (pp_3[23], pp_4[21], pp_5[19], s10, c10);
wire s11 ,c11;
ha ha11 (pp_6[17], pp_7[15], s11, c11);
wire s12 ,c12;
fa fa12 (pp_0[30], pp_1[28], pp_2[26], s12, c12);
wire s13 ,c13;
fa fa13 (pp_3[24], pp_4[22], pp_5[20], s13, c13);
wire s14 ,c14;
fa fa14 (pp_6[18], pp_7[16], pp_8[14], s14, c14);
wire s15 ,c15;
ha ha15 (pp_9[12], pp_10[10], s15, c15);
wire s16 ,c16;
fa fa16 (pp_0[31], pp_1[29], pp_2[27], s16, c16);
wire s17 ,c17;
fa fa17 (pp_3[25], pp_4[23], pp_5[21], s17, c17);
wire s18 ,c18;
fa fa18 (pp_6[19], pp_7[17], pp_8[15], s18, c18);
wire s19 ,c19;
ha ha19 (pp_9[13], pp_10[11], s19, c19);
wire s20 ,c20;
fa fa20 (pp_0[32], pp_1[30], pp_2[28], s20, c20);
wire s21 ,c21;
fa fa21 (pp_3[26], pp_4[24], pp_5[22], s21, c21);
wire s22 ,c22;
fa fa22 (pp_6[20], pp_7[18], pp_8[16], s22, c22);
wire s23 ,c23;
fa fa23 (pp_9[14], pp_10[12], pp_11[10], s23, c23);
wire s24 ,c24;
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
assign OUT[51] = p_0[51] ^ g_6_50;
assign OUT[52] = p_0[52] ^ g_6_51;
assign OUT[53] = p_0[53] ^ g_6_52;
assign OUT[54] = p_0[54] ^ g_6_53;
assign OUT[55] = p_0[55] ^ g_6_54;
assign OUT[56] = p_0[56] ^ g_6_55;
assign OUT[57] = p_0[57] ^ g_6_56;
assign OUT[58] = p_0[58] ^ g_6_57;
assign OUT[59] = p_0[59] ^ g_6_58;
assign OUT[60] = p_0[60] ^ g_6_59;
assign OUT[61] = p_0[61] ^ g_6_60;
assign OUT[62] = p_0[62] ^ g_6_61;
assign OUT[63] = p_0[63] ^ g_6_62;
assign OUT[64] = p_0[64] ^ g_6_63;
assign OUT[65] = p_0[65] ^ g_7_64;
assign OUT[66] = p_0[66] ^ g_7_65;
assign OUT[67] = g_7_66;
endmodule

module ha (
    input wire a,
    input wire b,
    output wire s,
    output wire c);

assign s = a ^ b;
assign c = a & b;
endmodule



module fa (
    input wire x,
    input wire y,
    input wire z,
    output wire s,
    output wire c);

assign s = x ^ y ^ z;
assign c = (x & y) | (x & z) | (y & z);
endmodule
