KASIRGA-KIZIL/tekno-kizil/vivado/cevreleyici/teknofest_ram_basys3.v

`timescale 1ns / 1ps
//////////////////////////////////////////////////////////////////////////////////
// Company: TUBITAK TUTEL
// Engineer:
//
// Create Date: 27.04.2022 10:41:19
// Design Name: TEKNOFEST
// Module Name: teknofest_ram
// Project Name: TEKNOFEST
// Target Devices: Nexys A7
// Tool Versions:
// Description:
//
// Dependencies:
//
// Revision:
// Revision 0.01 - File Created
// Additional Comments:
//
//////////////////////////////////////////////////////////////////////////////////


module teknofest_ram_basys3 #(
  parameter NB_COL = 4,
  parameter COL_WIDTH = 8,
  parameter RAM_DEPTH = 131072,
  parameter INIT_FILE = "C:/Users/TUTEL/Desktop/TEKNOFEST/tekno_sw/outputs/hex/uart_test.hex"
)
(
  input clk_i,
  input rst_ni,

  input [clogb2(RAM_DEPTH-1)-1:0] wr_addr,
  input [clogb2(RAM_DEPTH-1)-1:0] rd_addr,
  input [(NB_COL*COL_WIDTH)-1:0]  wr_data,
  input [NB_COL-1:0]              wr_strb,
  output [(NB_COL*COL_WIDTH)-1:0] rd_data,

  input  rd_en,
  input  ram_prog_rx_i,
  output system_reset_o,
  output prog_mode_led_o
    );

localparam CPU_CLK   = 60_000_000;   //Default CPU frequency on FPGA
localparam BAUD_RATE = 9600;          //Default Baud rate for programming on the run via UART

reg [(NB_COL*COL_WIDTH)-1:0] ram [RAM_DEPTH-1:0];
reg [(NB_COL*COL_WIDTH)-1:0] ram_data;

wire [31:0] ram_prog_data;
wire        ram_prog_data_valid;

reg  [clogb2(RAM_DEPTH-1)-1:0] prog_addr;
wire [clogb2(RAM_DEPTH-1)-1:0] wr_addr_ram;
wire [(NB_COL*COL_WIDTH)-1:0]  wr_data_ram;

assign wr_addr_ram = (prog_mode_led_o && ram_prog_data_valid) ? prog_addr : wr_addr;
assign wr_data_ram = (prog_mode_led_o && ram_prog_data_valid) ? ram_prog_data : wr_data;
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
