KASIRGA-KIZIL/tekno-kizil/(commit log)

2023-01-17 anliklari coz'de sec
2023-01-20 linting problemleri büyük oranda çözüldü crypt.v dosyası klasöre taşındı
    [conv.v, crypt.v, hamming_distance.v, popcount.v, rvrs_unit.v, zero_counter.v]
2023-01-21 yurute dallanma ongorucu sinyallerini ekle
    yurut yorum ekle
    tanimlar.vh yapayzeka instruction'indaki bugi duzelt
    [yurut.v]
2023-02-02 hata duzelt. Resetten sonraki ilk buyruk gecersiz.
    [denetim_durum_birimi.v]
2023-02-05 uart_alici eklendi
2023-02-05 uart_verici eklendi
2023-02-06 bolme birimi baslamadiysa resetle
    [bolme_birimi.v]
2023-02-06 carpma birimi testlerini duzenle, uart dntlyci ekl Uart denetleyici tamamlanmadı
2023-02-06 uart kontrolcu guncelle, alici eksik Cocotb dosysı sadece çıkışlara bakmak için herhangi bir kontrol yapılmaz
2023-02-07 uart denetleyici rx ve tx testiyle eklendi
2023-02-09 PWM ekle
2023-02-09 wishbone uart tamamlandi
2023-02-09 veriyolu ile uart denendi, calistirildi
2023-02-09 PWM hata duzelt
2023-02-09 SPI ekle
2023-02-09 pwm ve uart user processor'a bağla
2023-02-10 veriyolu bugfix, zero_counter bugfix
    [test_veriyolu.py, veriyolu.v, zero_counter.v]
2023-02-12 sadelestir. UART denetleyici ve verici
2023-02-12 sadelestir. uart alici.
2023-02-13 hata duzelt. uart rx input olmaliydi
2023-02-13 hata duzelt. veriyolu spi yonu
    vivado dosyalarini guncelle
2023-02-14 coremarki guncelle
    timer ve uart fonksiyonlarini ekle
2023-02-14 uart program gonderme scripti ekle
2023-02-14 uart scriptinde hata duzelt
2023-02-15 hata duzelt. Multiple constant drivers
2023-02-15 uart demo ekle
    main fonksiyonunu basa al
2023-02-15 hata duzelt. uart reset degerleri
    [uart_denetleyici.v]
2023-02-16 uart'a cocuk kolluklari tak. 1 byte gonder 1 byte bekle
    uart'a kilit tak. istesek de buffer patlamiyor.
    hata duzelt dallanma ongorucu
2023-02-16 el yapimi test ekle
    hata duzelt bolmeden sonra gelen carpma
    hata duzelt bolme isaretler xx
    carpma durdurmayi sil
    carpma delayi kaldir
    carpmayi yonlendir
    carpmayi gy'den kaldir
2023-02-16 el yapimi testleri gelistir
2023-02-16 uart timer demosu ekle
2023-02-16 uart timer demosunda standart kutuphane kullanma
2023-02-16 hata duzelt. timer
2023-02-18 hata duzelt. bit uzunluklari
    hata duzelt. eksik case'ler
    hata duzelt. cakisan case'ler
    ps'i optimize et
    verilator icin temizlik yap
    testler'i temizlemek icin makefile ekle
    gereksiz dosyalari sil
2023-02-18 el yapimi testleri gelistir
    hata duzelt. veri onbellegi maske
2023-02-20 timer demosunu guncelle
    saniye saniye say
2023-02-21 random testler'de kirli satirlari en son geri yazdir.
2023-02-23 pwm'yi wb ye uydur
2023-02-23 pwm'ye maske ekle
2023-02-23 pwm'yi bagla
2023-02-23 pwm demosu ekle
2023-02-26 spi denetleyici bastan yazildi (alt modulsuz)
2023-02-26 pwm demo c kodunu duzelt
    pwm demoyu testlere ekle
    make'i guncelle
2023-02-26 spi verici testi yapildi
2023-02-27 cevreleyici timer hatasini duzelt
2023-02-28 8 bit bugfix. bitiste hata olabilir
    [spi_denetleyici.v]
2023-02-28 spi chipselect bugfix
2023-03-01 spi read düzeltildi
2023-03-01 spi test ekler
2023-03-01 spi wishbone uyumlu
2023-03-01 spi veriyoluna bağla, test adreslerini düzelt
2023-03-02 spi bit hatasi duzelt
2023-03-02 spi bit hatalarini düzeltir
2023-03-02 spi bit hatalarini düzeltir2
2023-03-06 spi cevreleyiciye baglar
2023-03-06 cekirdek openlane config ekle
    [pin_order.cfg]
2023-03-12 spi denetleyici sıra hata duzeltme
2023-03-12 el yapimi carpma testini gelistir.
2023-03-14 openlane buyruk onbellegi ekle
    [pin_order.cfg]
2023-03-18 ramsiz openlane config ekle
    [pin_order.cfg]
2023-03-18 dffram pin lokasyonlarini ekle
    [pin_order.cfg]
2023-03-19 cekirdek_ramsiz pin openlane degistir.
    [pin_order.cfg]
2023-03-19 dffram port lokasyonlarini guncelle
    [pin_order.cfg]
2023-03-20 openlane scriptlerini gelistir
    [pin_order.cfg]
2023-03-21 cekirdek ramsiz pin sirasini tersine cevir
    [pin_order.cfg]
2023-04-02 openlane configlerini guncelle
    [pin_order.cfg]
2023-04-04 uart tetris oyunu ekle
2023-04-04 uartta donen donut ekle
2023-04-06 pwm bit hatasi duzelt
2023-04-07 openlane scriptlerini guncelle
    [pin_order.cfg]
2023-04-08 openlane dffram icin config ekle
    [pin_order.cfg]
2023-04-15 basys3 uart programlayici ekle
2023-04-15 el yapimi ram ekle
    ifdef OPENLANE ekle
    ram arayuzlerini duzelt
    uart demosunu degistir
    [pin_order.cfg]
2023-04-15 uart read fix
2023-04-16 uart bug'ını çözer
2023-04-16 uart programlayici guncelle
2023-04-16 spi'dan gereksiz yazmaclari kaldir
2023-04-16 uart testini gelistir
2023-04-16 uart update
2023-04-16 pwm yazim hatasi duzelt
2023-04-16 spi'a yorum ekler
2023-04-17 pwm'e yorum ekle
2023-04-17 spi hata duzeltme
2023-04-17 spi hata duzelt2
2023-04-17 arduino slave kodunu ekler
2023-04-17 openlane dosyalarini ekle
    [metrics.csv]
2023-04-17 openlane linklerini top README ye de koy
